hectorvicario/2wd/5_MEDIA/Vista lateral derecha_Hector.jpg

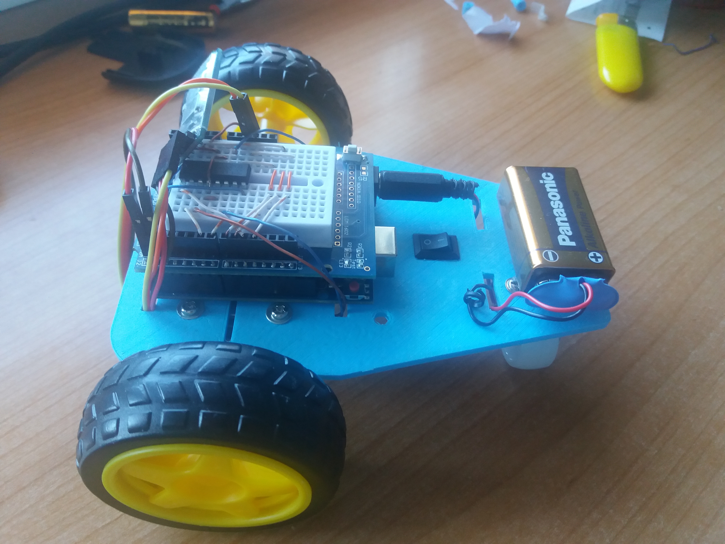
5_MEDIA/Vista lateral derecha_Hector.jpg
