hectorvicario/2wd/5_MEDIA/Cableado de la placa_Hector.jpg

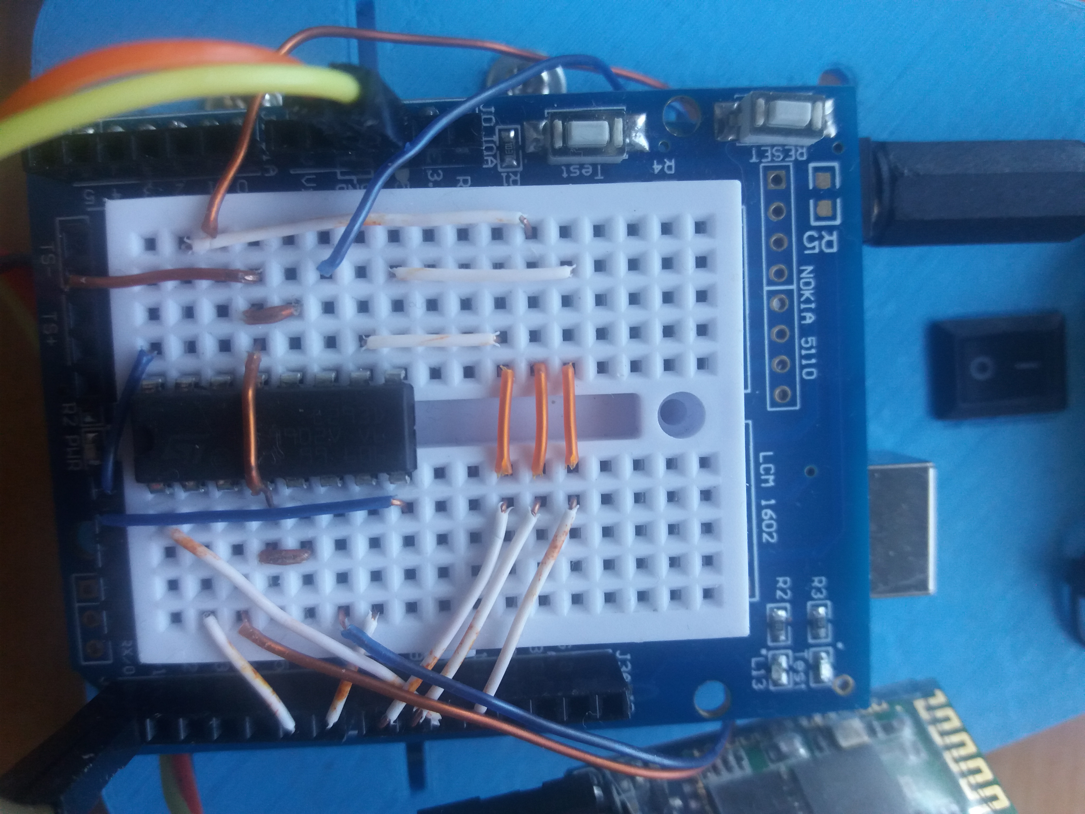
5_MEDIA/Cableado de la placa_Hector.jpg
