hectorvicario/2wd/5_MEDIA/Despiece_Hector.jpg

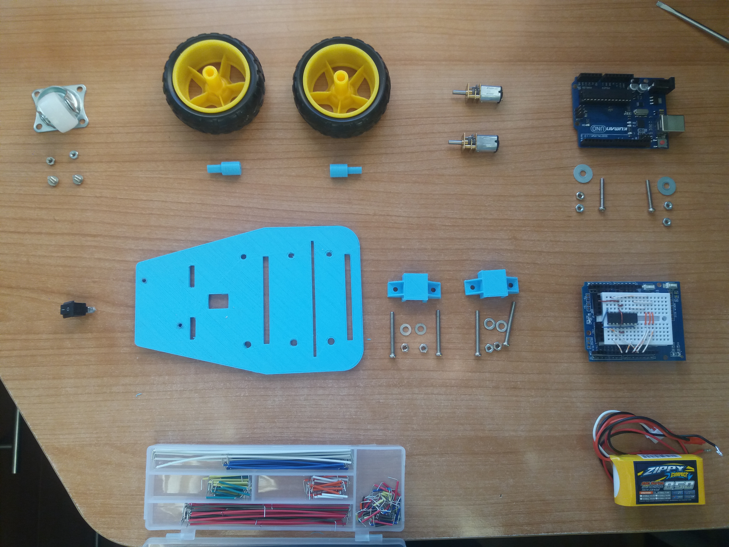
5_MEDIA/Despiece_Hector.jpg
