hectorvicario/2wd/5_MEDIA/Vista lateral izquierdo_Hector.jpg

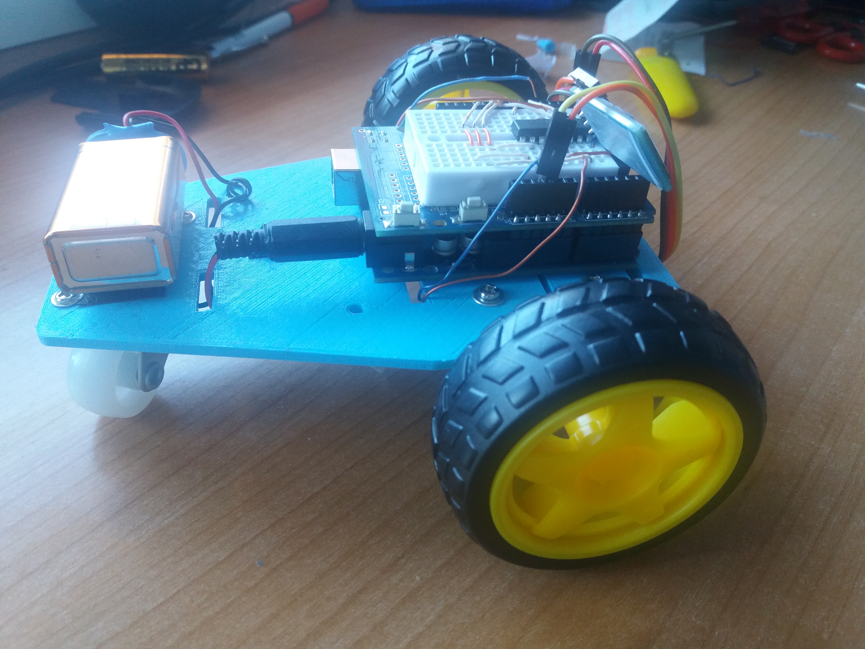
5_MEDIA/Vista lateral izquierdo_Hector.jpg
