hectorvicario/2wd/5_MEDIA/Vista trasera_Hector.jpg

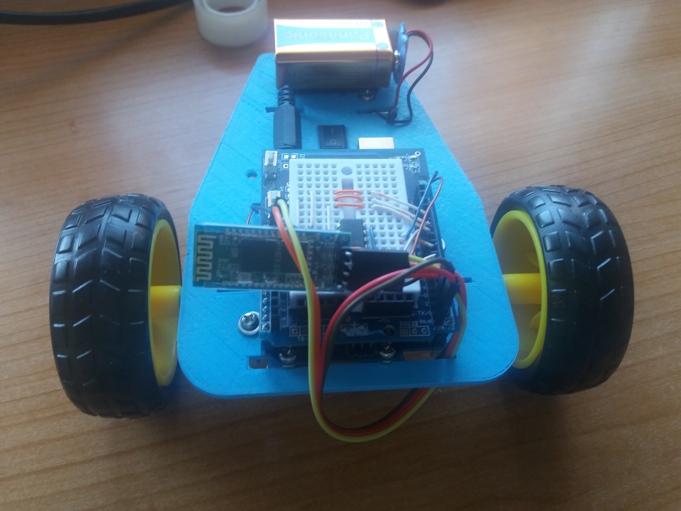
5_MEDIA/Vista trasera_Hector.jpg
