hectorvicario/2wd/3_3D_PIECES/piezas en formato FCStd/Acople_eje_polulu_Hector.FCStd

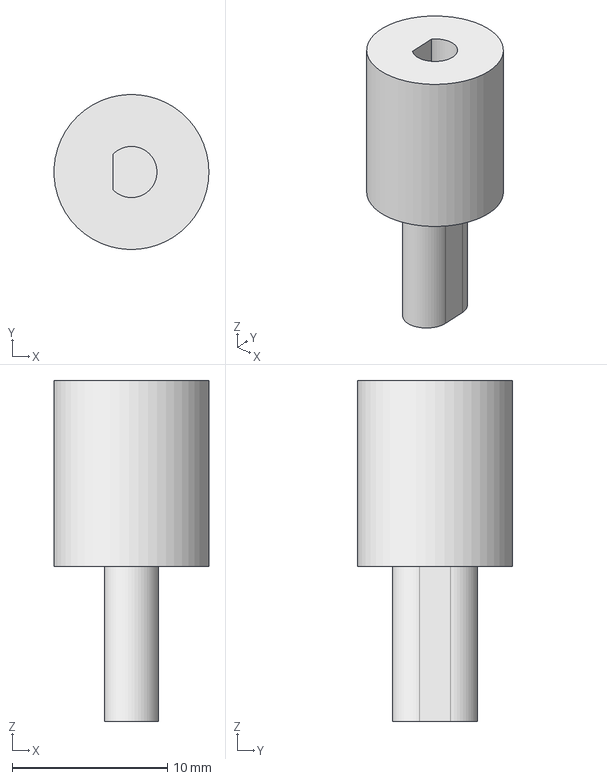
[picture p14: CAD file, 2018-02-26]
3_3D_PIECES/piezas en formato FCStd/Acople_eje_polulu_Hector.FCStd
9.99 x 10.00 x 22.0 mm
