hectorvicario/2wd/3_3D_PIECES/piezas en formato FCStd/Base_robot_Hector.FCStd

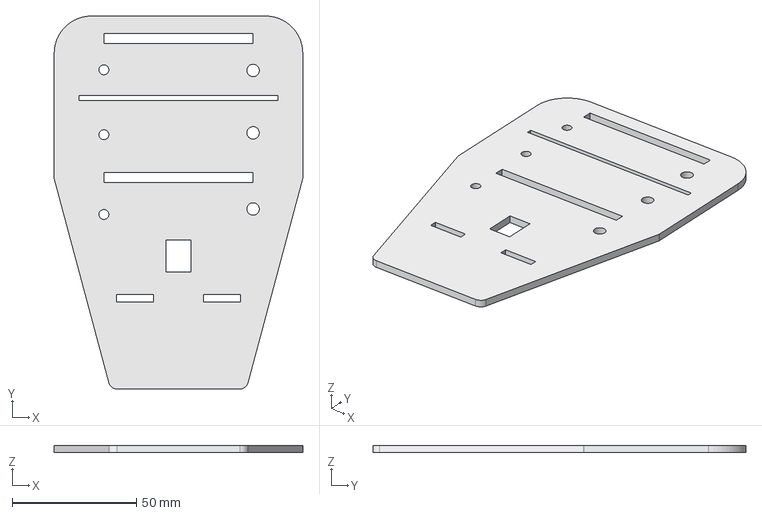
[picture p15: CAD file, 2018-02-26]
3_3D_PIECES/piezas en formato FCStd/Base_robot_Hector.FCStd
100.0 x 150.0 x 3.00 mm
