hectorvicario/2wd/3_3D_PIECES/piezas en formato FCStd/Soporte_motor_polulu_Hector.FCStd

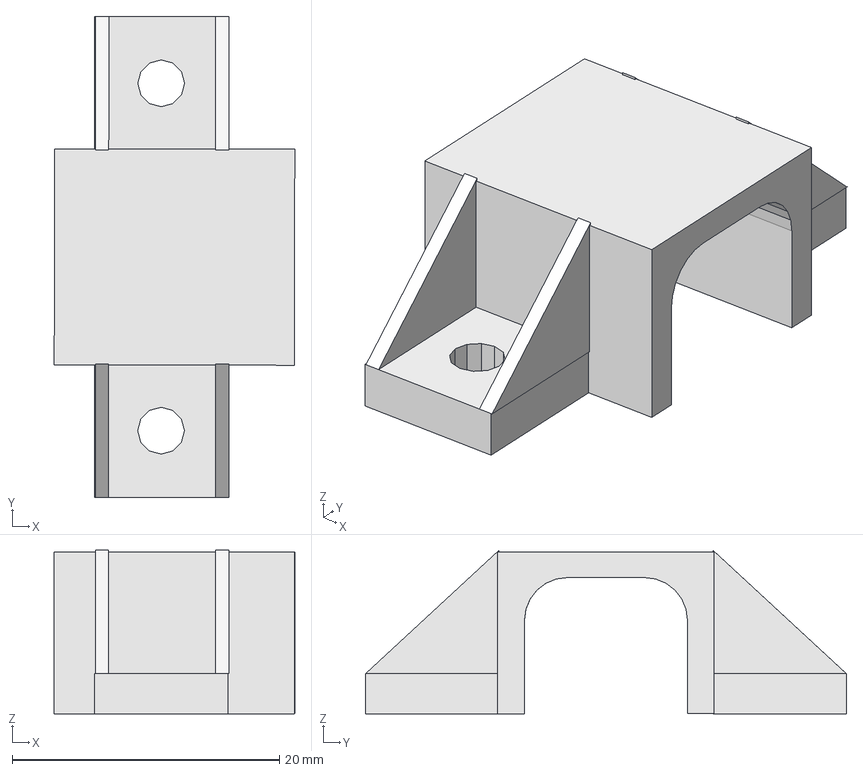
[picture p16: CAD file, 2018-02-26]
3_3D_PIECES/piezas en formato FCStd/Soporte_motor_polulu_Hector.FCStd
18.0 x 36.0 x 12.3 mm
