hectorvicario/2wd/(list of files, cad)

Other CAD files:
3_3D_PIECES/piezas en formato STL/Acople_eje_polulu_Hector.stl
3_3D_PIECES/piezas en formato STL/Base_robot_Hector.stl
3_3D_PIECES/piezas en formato STL/Soporte_motor_polulu_Hector.stl
