hectorvicario/2wd/2_MANUAL_DE_USUARIO/Esquemas eléctricos_Hector.docx

Esquemas eléctricos

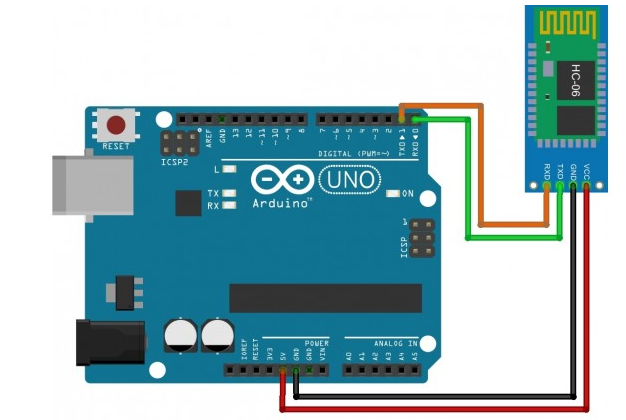
[picture p18: figure]

Conexión del modulo bluetooth

Conexión de los motores con driver L293

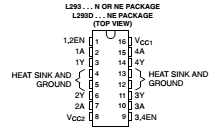
[picture p19: figure]
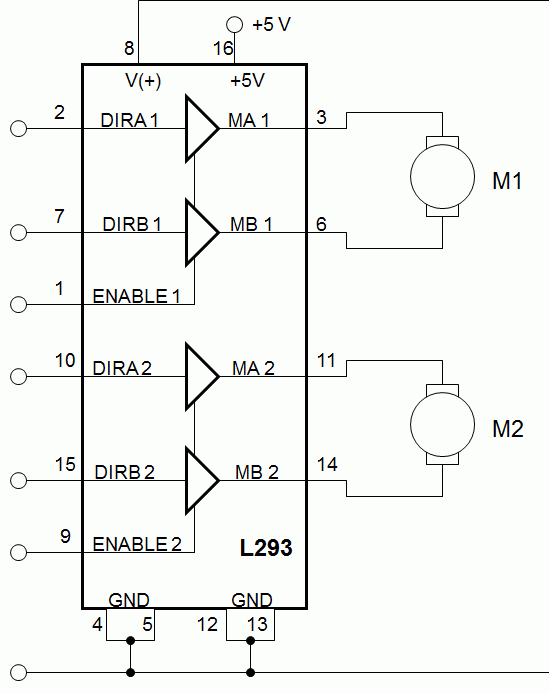
[picture p20: figure]
L293hookup

Esquema eléctrico de la shield

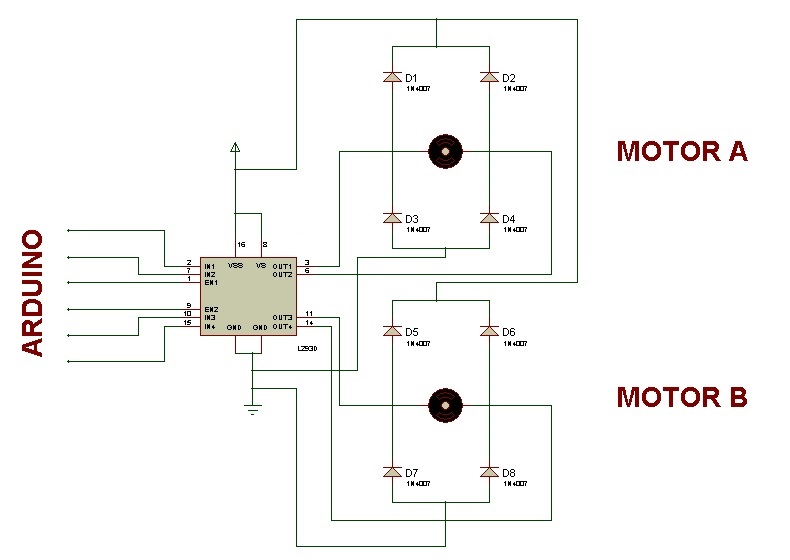
[picture p21: figure]
