hectorvicario/2wd/2_MANUAL_DE_USUARIO/Descripción del funcionamiento_Hector.docx

Descripción del funcionamiento

El robot 2WD teledirigido lo controlaremos a través de una app del teléfono móvil llamada bluetooth RC. Desde esta aplicación podemos realizar varios movimientos gobernados por el usuario.

1-Marcha adelante:

2-Marcha atrás:

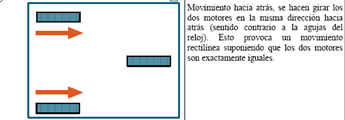
[picture p22: figure]

3-Giro a izquierda:

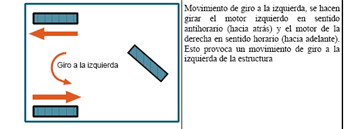
[picture p23: figure]

4-Giro a derecha:

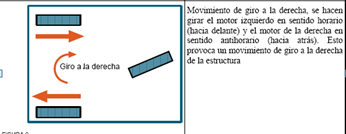
[picture p24: figure]

5-Michael jackson :

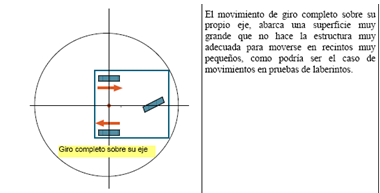
[picture p25: figure]
