hectorvicario/2wd/5_MEDIA/Planta_Hector.jpg

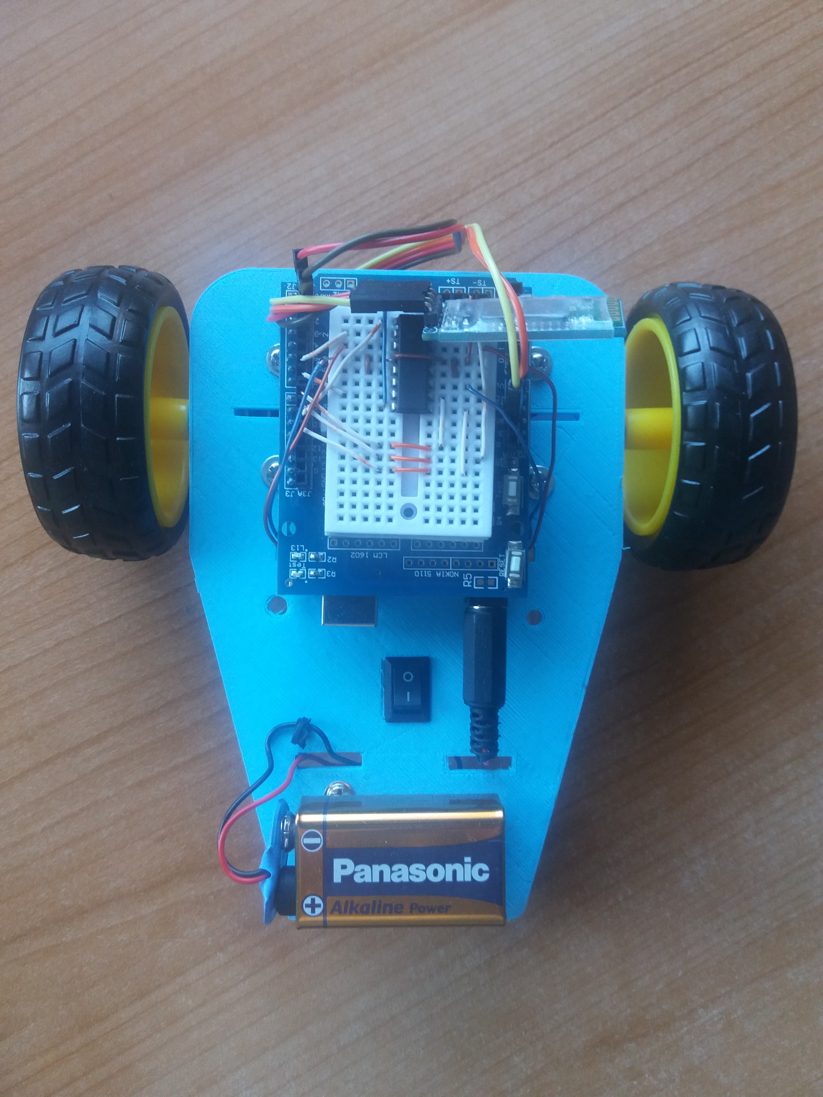
5_MEDIA/Planta_Hector.jpg
